Graddery/graduate-work/1.jpg

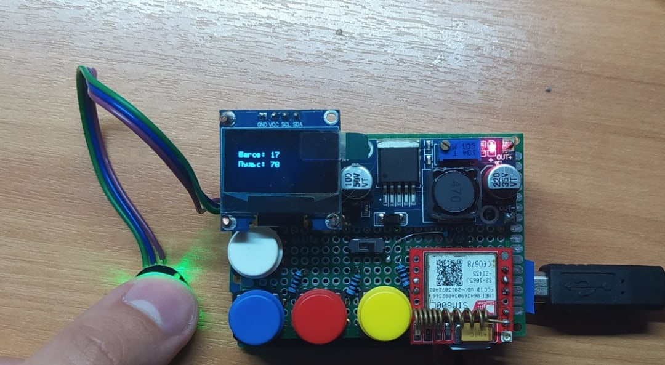
1.jpg
