Graddery/graduate-work/2.jpg

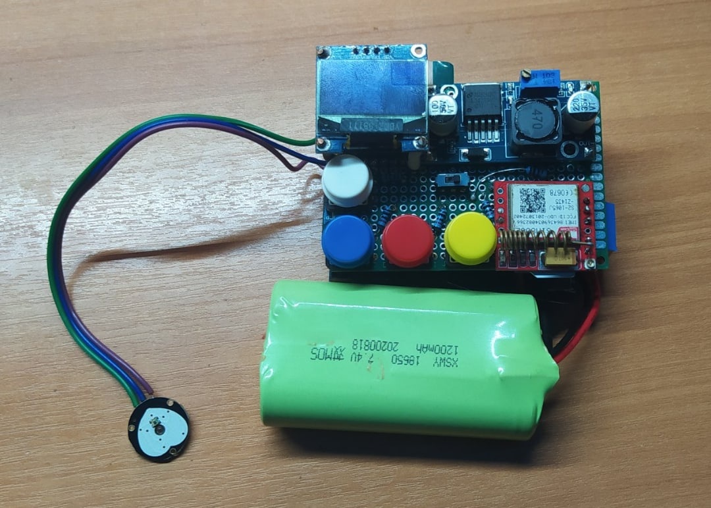
2.jpg
