Graddery/graduate-work/presentation.pptx

## ДИПЛОМНЫЙ ПРОЕКТ Тема:Разработка прототипа трекера по контролю состояния человека с ОВЗ

Специальность: 09.02.01
Компьютерные системы и комплексы

Исполнитель: студент группы КС-42
Лытченко-Меткий О.Д.

## Теоретический раздел


Микроконтроллер

Дисплей OLED 0.96 дюймов, I2C, монохромный белый

OLED дисплей

Czujnik-pulsu-serca-pulsomierz-Arduino

Датчик пульса

module-GSM-GPRS-SIM800L

GSM модуль

6-осевой сенсорный модуль GY-6500 (MPU-6500)

Гироскоп-акселерометр

2S-7-4-8-4-USB

Модуль заряда батареи

$_12

Понижающий преобразователь

## Технологический раздел

Difference-Between-Analog-and-Digital-Pins-in-Arduino-UNO

Рассмотрение распиновки
платы микроконтроллера

С температурой дела обстоят также — при превышении пороговых значений (-30...80°С), сначала предупреждение, потом выключение

График среднего потребляемого
напряжения GSM модуля

de8cy5nyO8BLx6jozfYpcxOMpmZ-NMhgCbl2TH80vHPDrwqOj5ql_3MYrZgK0FHQLTTH0_3SF68B6XhfkqCl3lNZ

Проведение теста на
работоспособность дисплея

995f63e6-eff8-4c62-88b1-6eb56dcbdcc6

Различные делители напряжения используемые в проекте

## Экономический раздел

Различные аналоги присутствующие на рынке

Расчет себестоимости прототипа

Компонент | Итоговая цена, руб.
Пульсометр | 261,16
Модуль зарядки аккумуляторов | 232,60
GSM модуль | 384,97
OLED дисплей | 235,65
Гироскоп-акселерометр | 215,59
Аккумулятор | 250
Понижающий модуль питания | 72,36
Микроконтроллер в комплекте | 611,60
Кнопки | 34,33
Резисторы | 4,38
Печатная плата | 34,49
Сим-карта | 150
Припой | 96,76
Флюс | 8,23
Медные проводники | 11,27
Алюминиевые проводники | 10,5
Итого | 2613,89

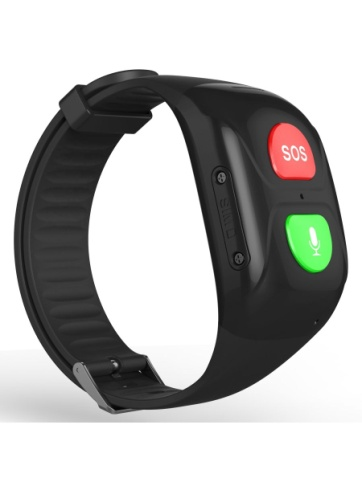
[picture p35: figure]
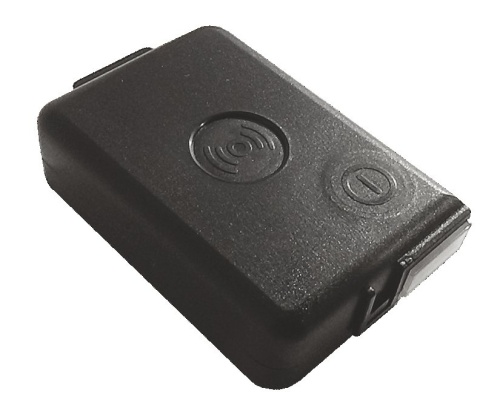
[picture p36: figure]
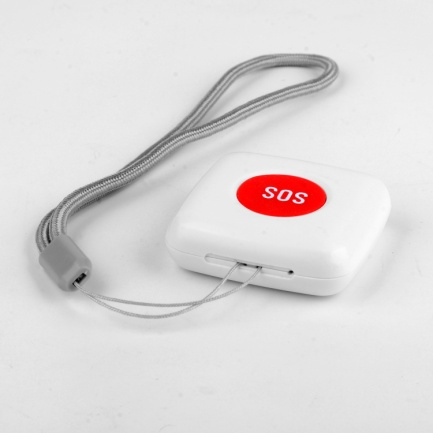
[picture p37: figure]

## Безопасность и экологичность проекта

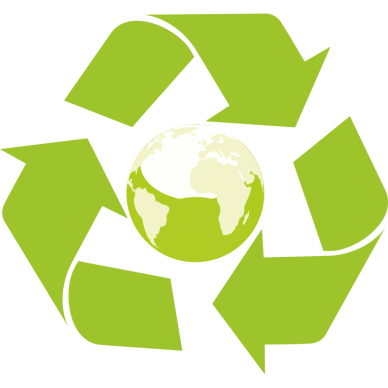
[picture p38: figure]

Методы соединения проводников разных металлов

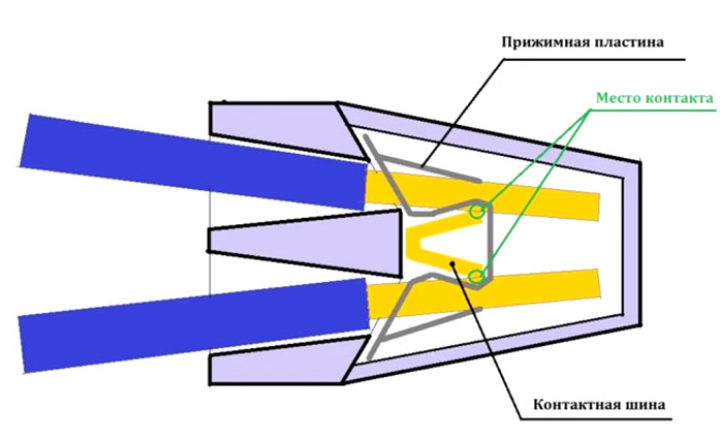
[picture p39: figure]
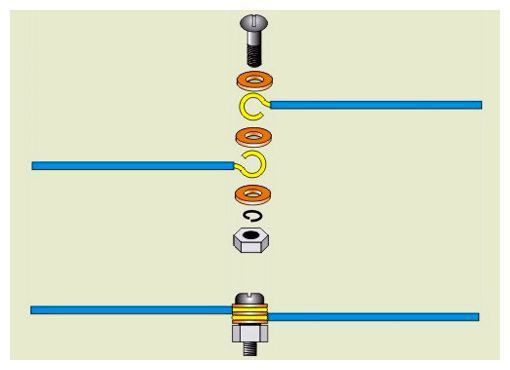
[picture p40: figure]
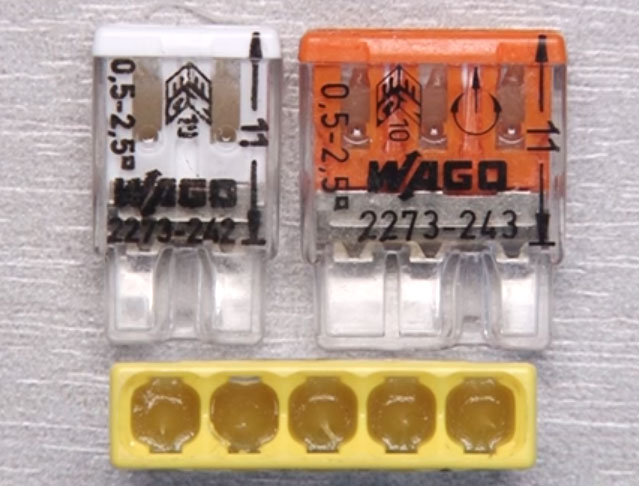
[picture p41: figure]
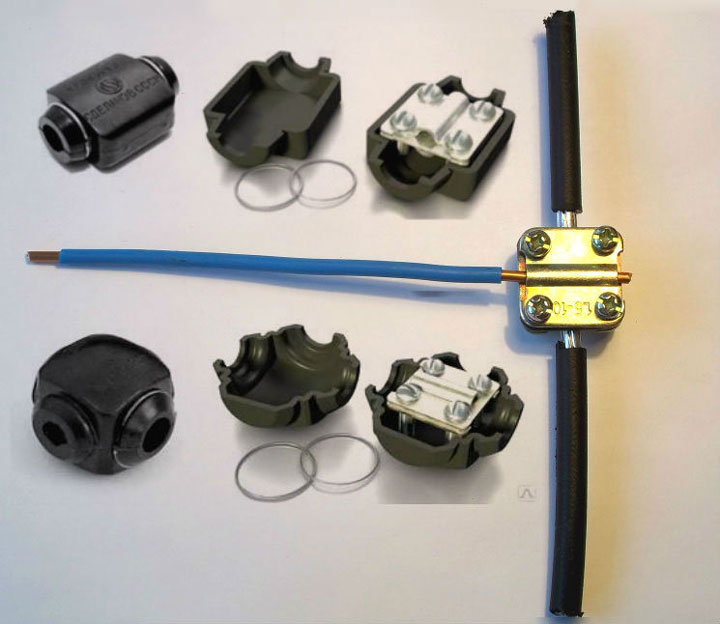
[picture p42: figure]
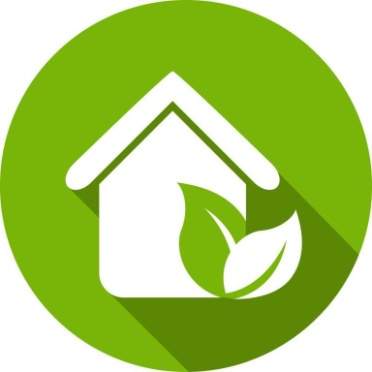
[picture p43: figure]

## Спасибо за внимание! Прошу, задавайте вопросы.
