Graddery/graduate-work/графическая часть горизонтальная.png

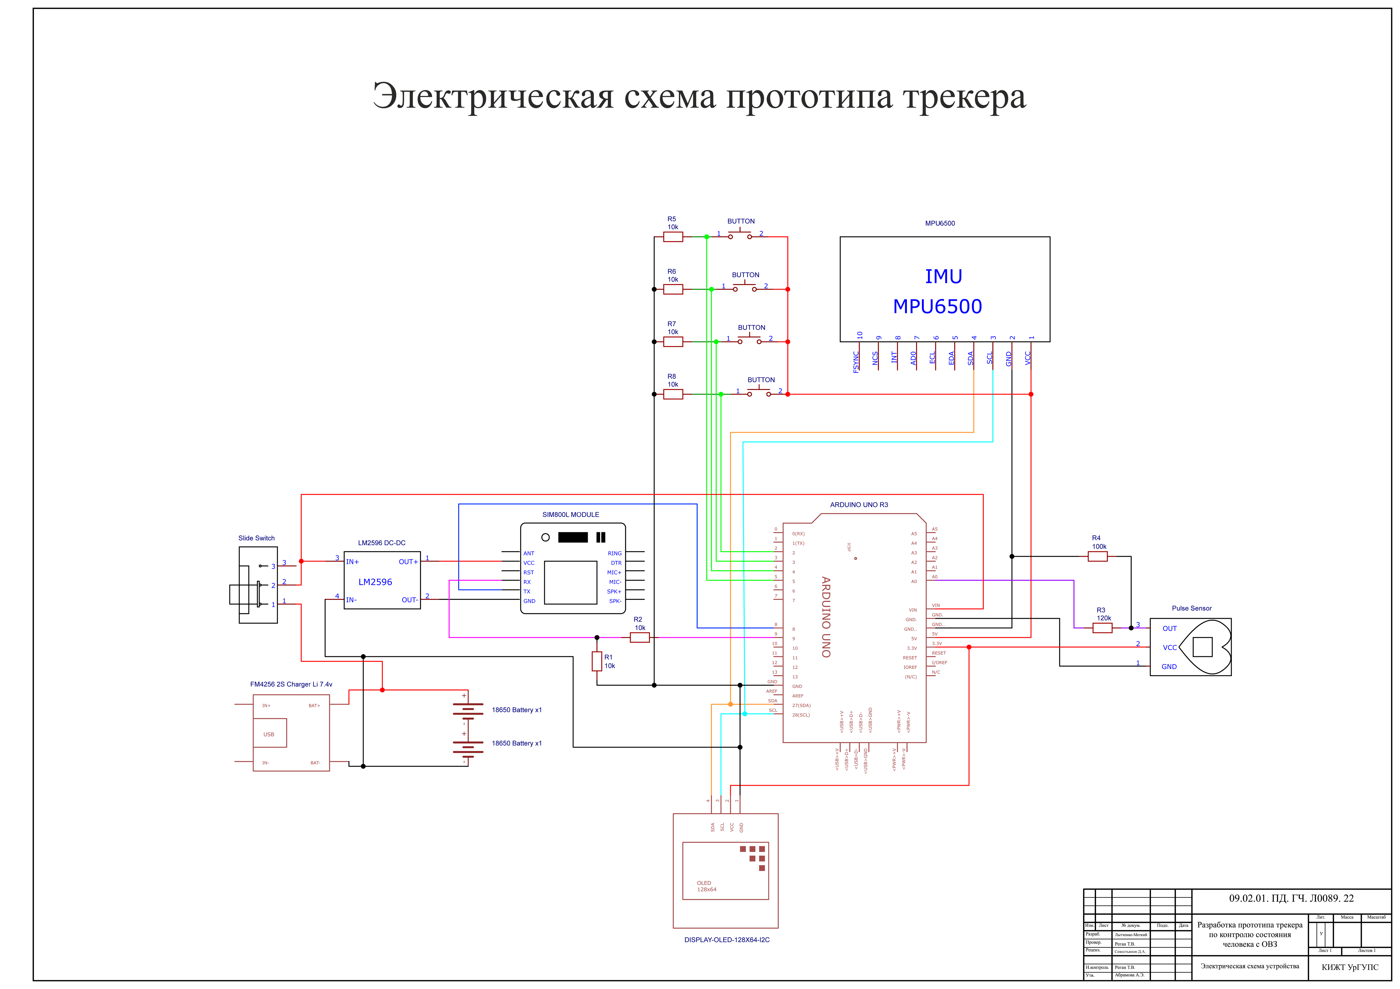
графическая часть горизонтальная.png
